clairemp25-prog/Projet-Piano-Num-rique-Ensea/Présentation finale.pdf

# PIANO NUMÉRIQUE

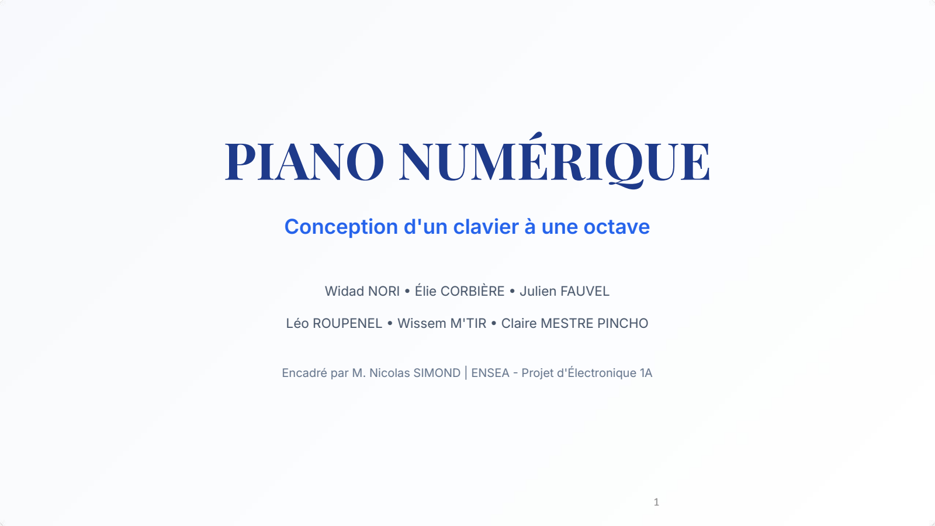
[picture p18: page 1]

## Conception d'un clavier à une octave

Encadré par M. Nicolas SIMOND | ENSEA Projet d'Électronique 1A

Widad NORI Élie CORBIÈRE Julien FAUVEL

Léo ROUPENEL Wissem M'TIR Claire MESTRE PINCHO

# Context & Introduction

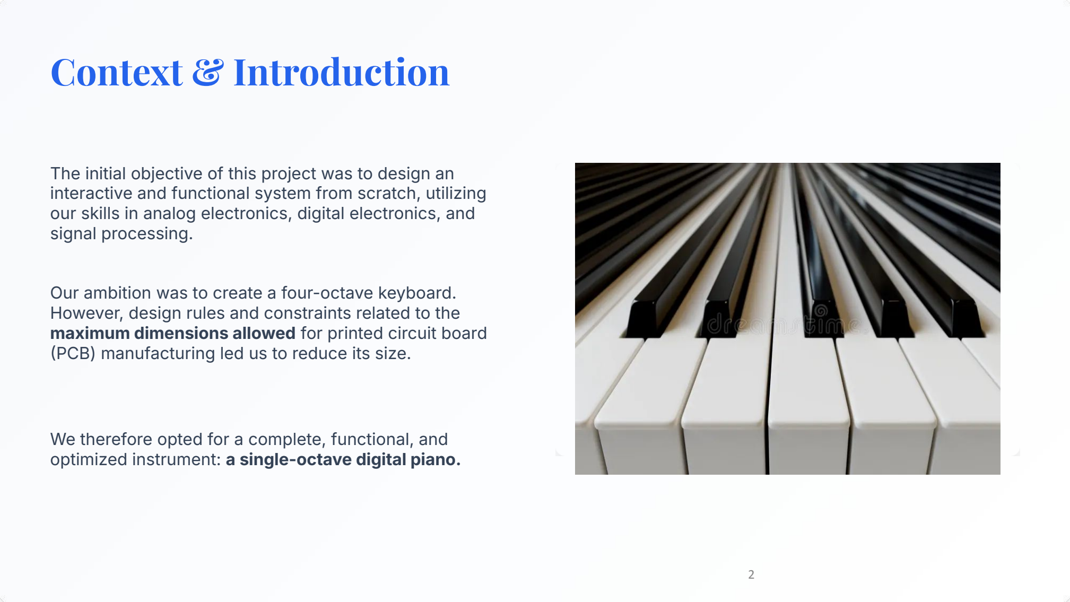
[picture p19: page 2]

The initial objective of this project was to design an interactive and functional system from scratch, utilizing our skills in analog electronics, digital electronics, and signal processing.

Our ambition was to create a four-octave keyboard. However, design rules and constraints related to the maximum dimensions allowed for printed circuit board PCB) manufacturing led us to reduce its size.

We therefore opted for a complete, functional, and optimized instrument: a single-octave digital piano.

# Project Specifications (SysML)

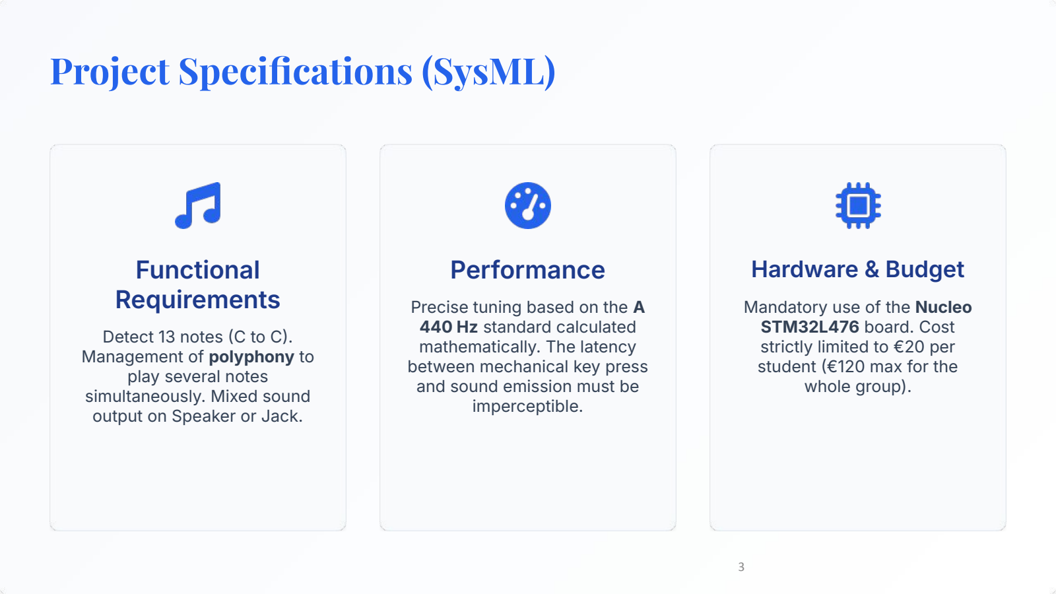
[picture p20: page 3]

## Functional Requirements

Detect 13 notes C to C.
Management of polyphony to play several notes
simultaneously. Mixed sound output on Speaker or Jack.

## Performance

Precise tuning based on the A 440 Hz standard calculated mathematically. The latency between mechanical key press and sound emission must be imperceptible.

## Hardware & Budget

Mandatory use of the Nucleo STM32L476 board. Cost
strictly limited to €20 per student €120 max for the
whole group).

# Diagramme SysML

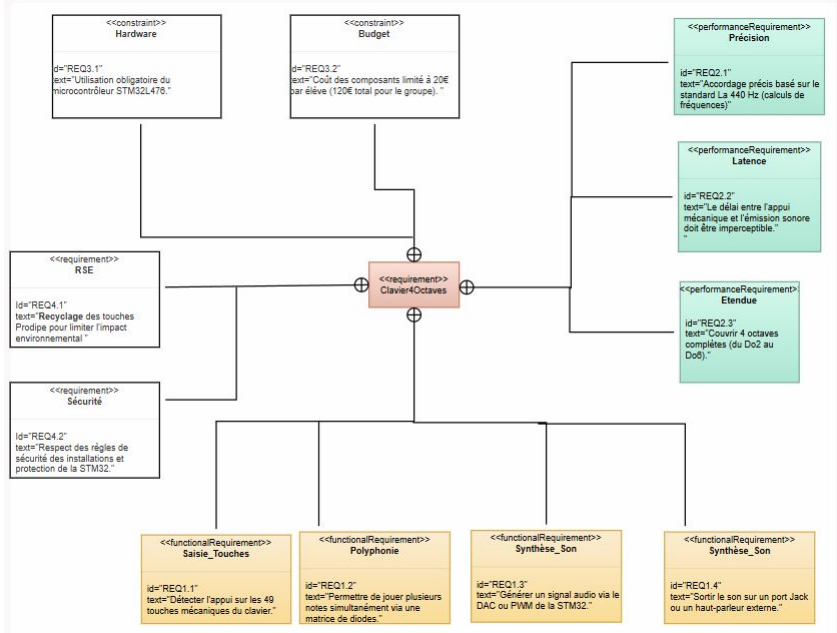
[picture p21: figure]

# System Architecture

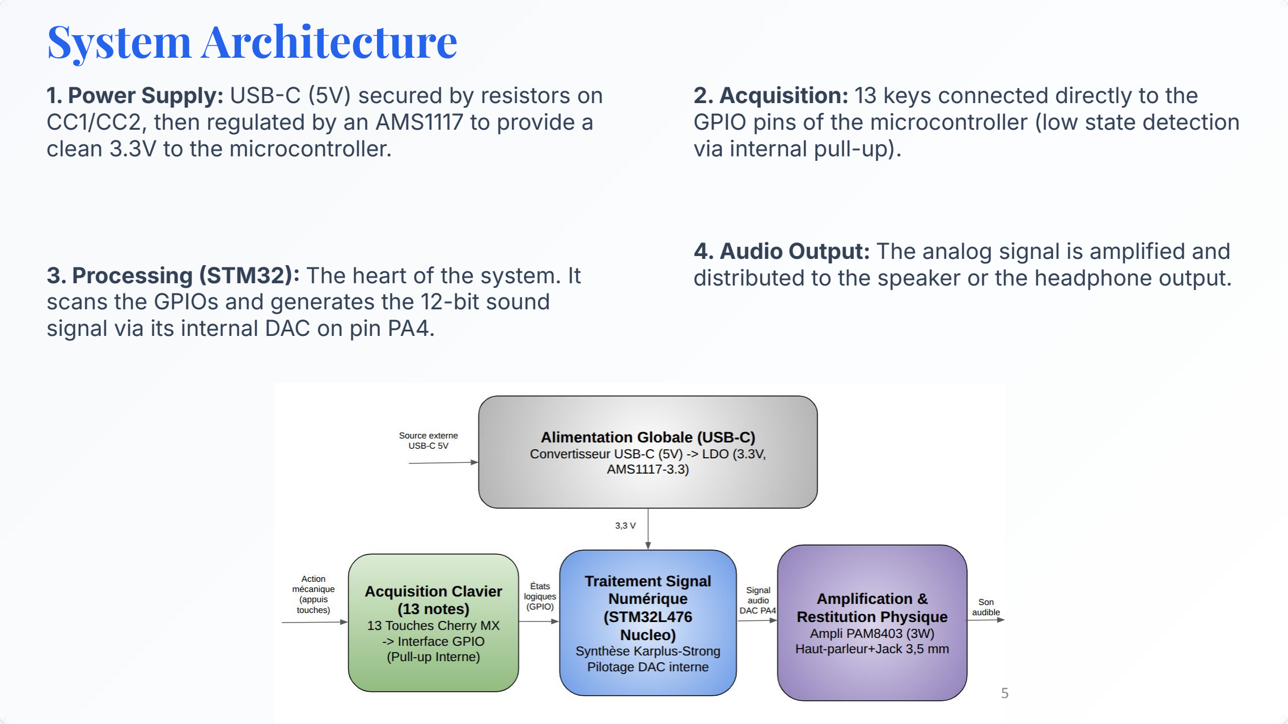
[picture p22: page 5]

### 1. Power Supply: USBC 5V) secured by resistors on

CC1/CC2, then regulated by an AMS1117 to provide a clean 3.3V to the microcontroller.

### 2. Acquisition: 13 keys connected directly to the

GPIO pins of the microcontroller (low state detection via internal pull-up).

### 3. Processing STM32 The heart of the system. It

scans the GPIOs and generates the 12-bit sound signal via its internal DAC on pin PA4.

### 4. Audio Output: The analog signal is amplified and

distributed to the speaker or the headphone output.

# Key Components

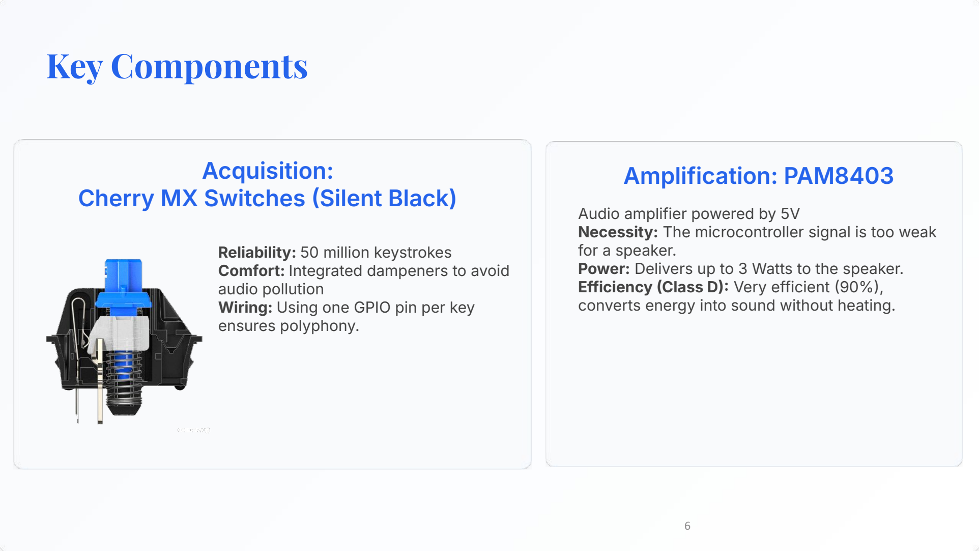
[picture p23: page 6]

## Acquisition: Cherry MX Switches Silent Black)

Reliability: 50 million keystrokes Comfort: Integrated dampeners to avoid audio pollution
Wiring: Using one GPIO pin per key ensures polyphony.

## Amplification: PAM8403

Audio amplifier powered by 5V
Necessity: The microcontroller signal is too weak for a speaker.
Power: Delivers up to 3 Watts to the speaker. Efficiency Class D Very efficient 90%, converts energy into sound without heating.

# List of components

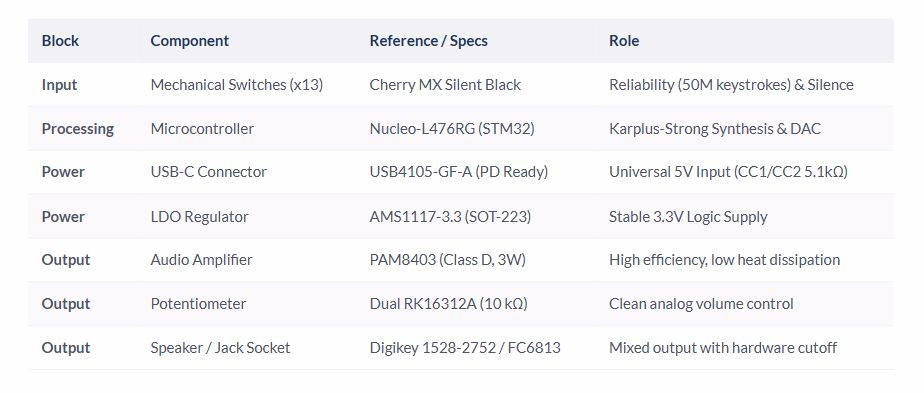
[picture p24: figure]
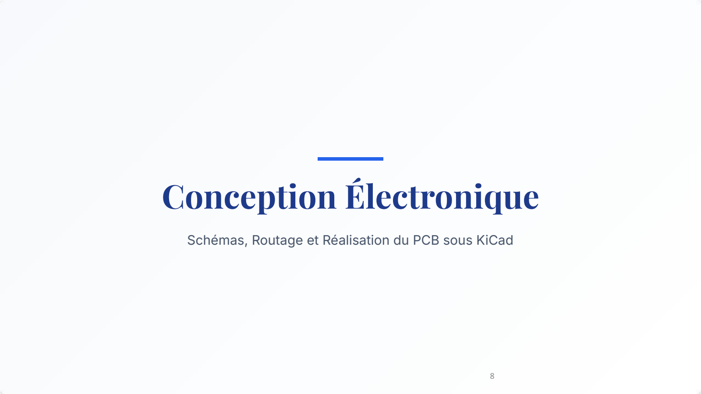
[picture p25: page 8]

# Conception Électronique

### Schémas, Routage et Réalisation du PCB sous KiCad

# CAO sous KiCad

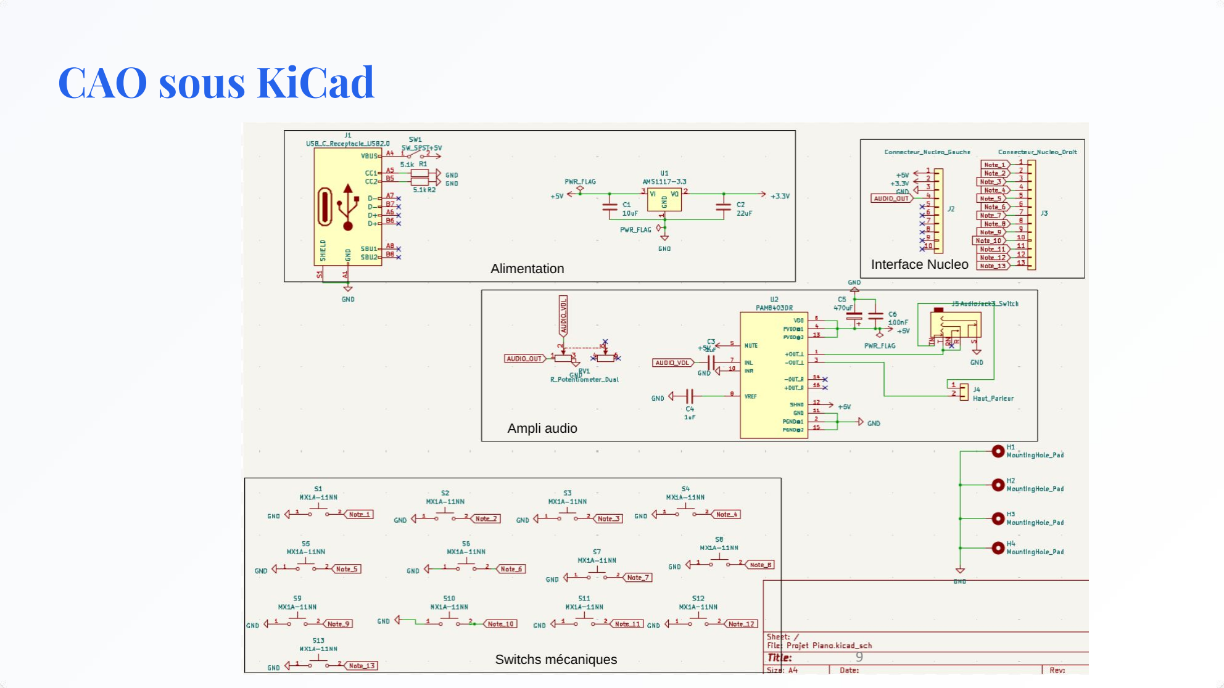
[picture p26: page 9]

# CONCEPTION DU PCB

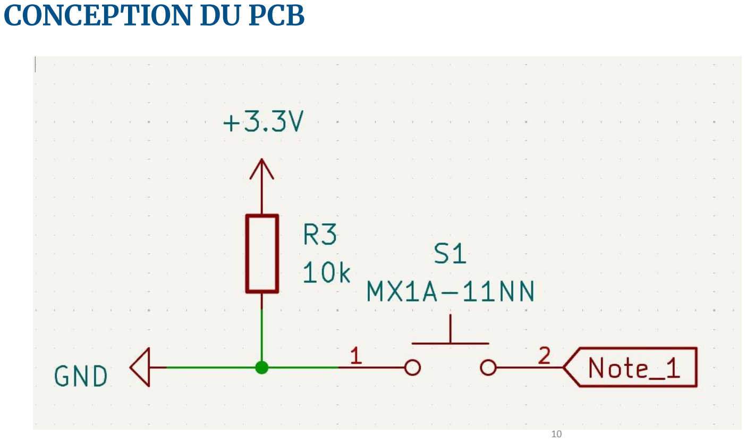
[picture p27: page 10]

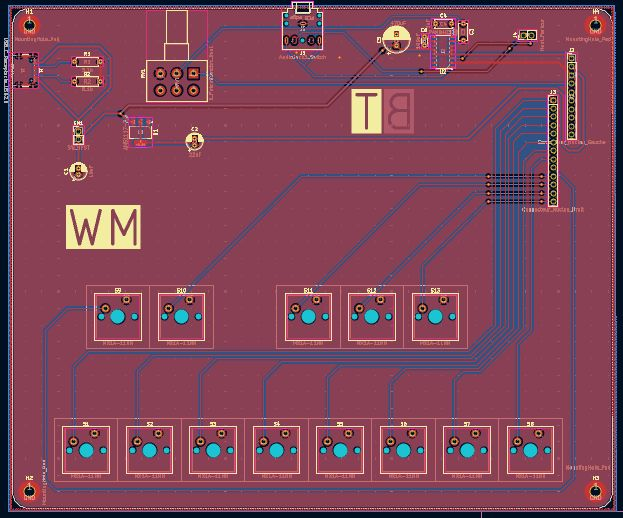
[picture p28: figure]

Routage 2 Couches

Pistes logiques au dos pour préserver le signal analogique de l'amplificateur en façade.

# CONCEPTION DU PCB

# CONCEPTION DU PCB

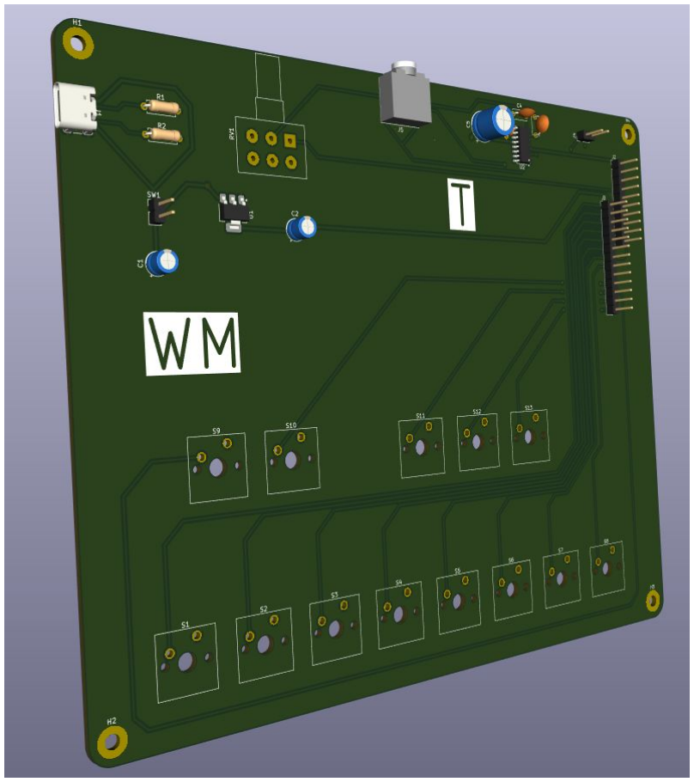
[picture p29: figure]

Vue 3D du PCB (KiCad)

"Shield" Format: The circuit was designed as an expansion board fitting directly onto the Nucleo via headers. This protects the microcontroller from permanent soldering.

Full Ground Plane: A copper fill connected to GND (zone fill) on both sides forms an essential electromagnetic shield to avoid background noise (hiss) in the audio signal.

Playing Ergonomics: The 13 Cherry MX footprints are precisely arranged to reproduce the standard spacing of a piano octave (aligned white keys, offset black keys).

USBC Security: Critical addition of two 5.1kΩ resistors on pins CC1/CC2 to force Power Delivery chargers to deliver only 5V (circuit protection).

# Printed Circuit Board Details

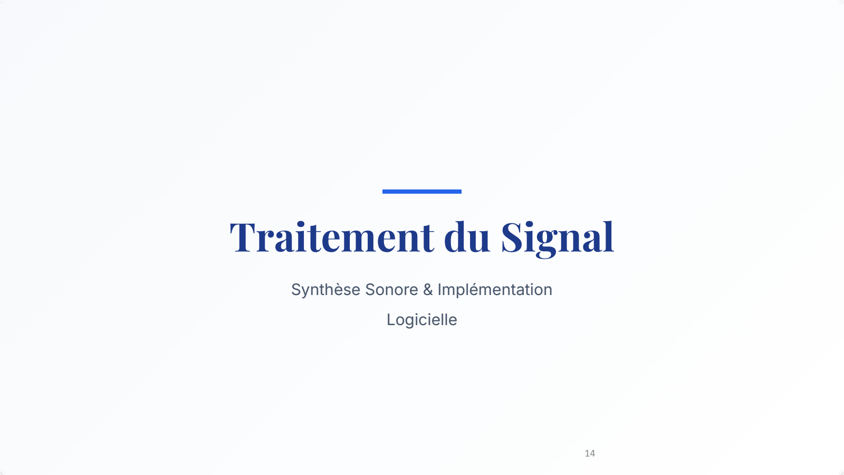
[picture p30: page 14]

# Traitement du Signal

### Synthèse Sonore & Implémentation Logicielle

# Algorithm Choice

To synthesize the piano sound, we had to choose between several methods:

- Additive synthesis: We add elementary signals to simulate a piano sound
- FM synthesis: Method using frequency modulation to synthesize a sound
- Karplus-Strong algorithm: A white noise loop is played back on itself and filtered with a low-pass filter

# Additive synthesis

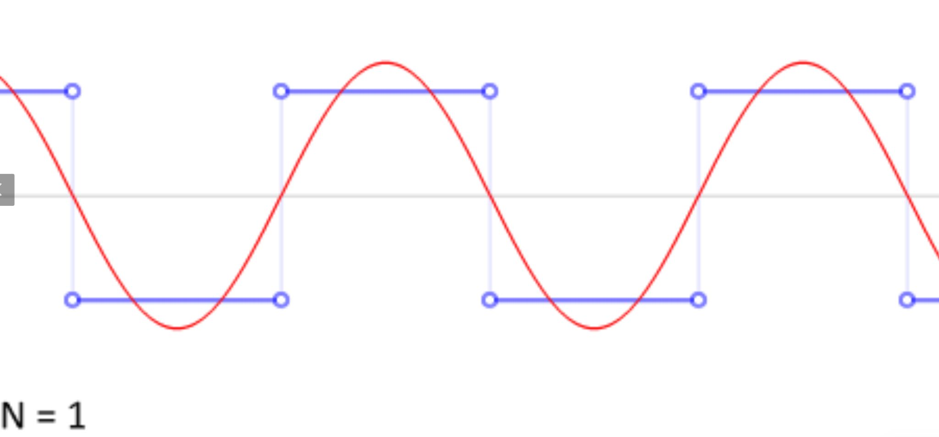
[picture p31: figure]

Pros and cons :
- Simple to implement: Very simple method
- Very heavy : If we want to synthesize a high-quality sound, we need a large amount of harmonics, which takes a lot of calculation time
- Rich sound: We directly control the amount of harmonics, the result can be rich and easily adjustable
- Originality : method with little interest

# Additive synthesis

Pros and cons :

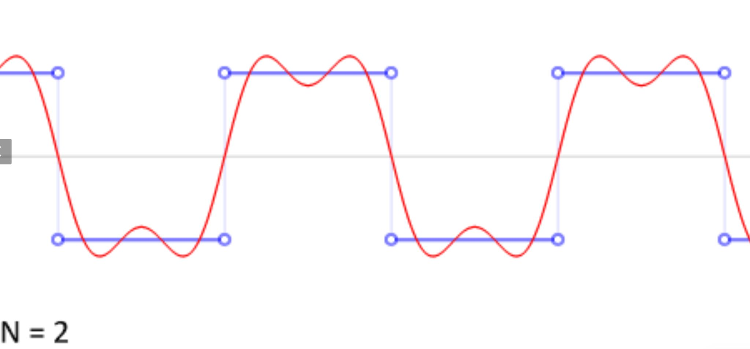
[picture p32: figure]

- Simple to implement: Very simple method
- Very heavy : If we want to synthesize a high-quality sound, we need a large amount of harmonics, which takes a lot of calculation time
- Rich sound: We directly control the amount of harmonics, the result can be rich and easily adjustable
- Originality : method with little interest

# Additive synthesis

Pros and cons :

- Simple to implement: Very simple method

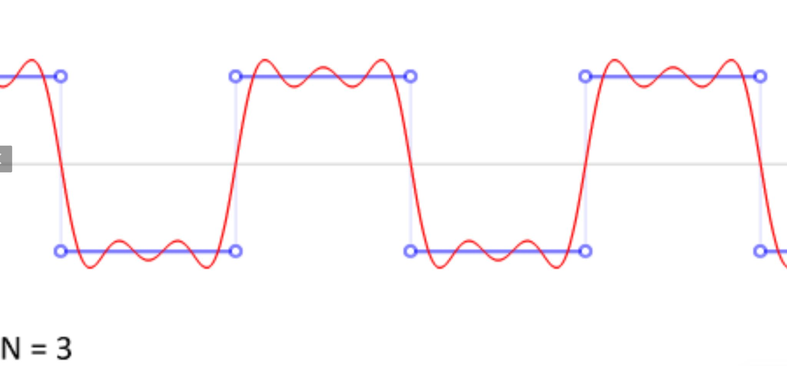
[picture p33: figure]

- Very heavy : If we want to synthesize a high-quality sound, we need a large amount of harmonics, which takes a lot of calculation time
- Rich sound: We directly control the amount of harmonics, the result can be rich and easily adjustable
- Originality : method with little interest

# FM Synthesis (frequency modulation)

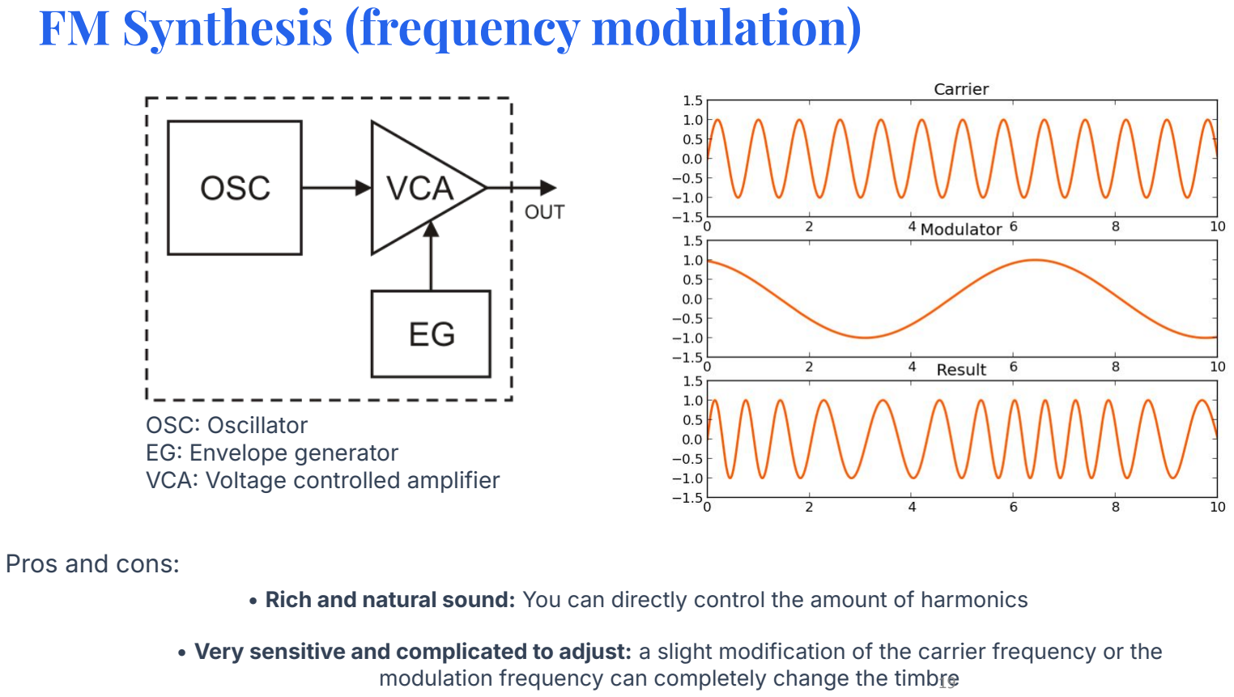
[picture p34: page 19]

OSC Oscillator
EG Envelope generator
VCA Voltage controlled amplifier

Pros and cons:
- Rich and natural sound: You can directly control the amount of harmonics
- Very sensitive and complicated to adjust: a slight modification of the carrier frequency or the modulation frequency can completely change the timbre19

# The Karplus-Strong Algorithm

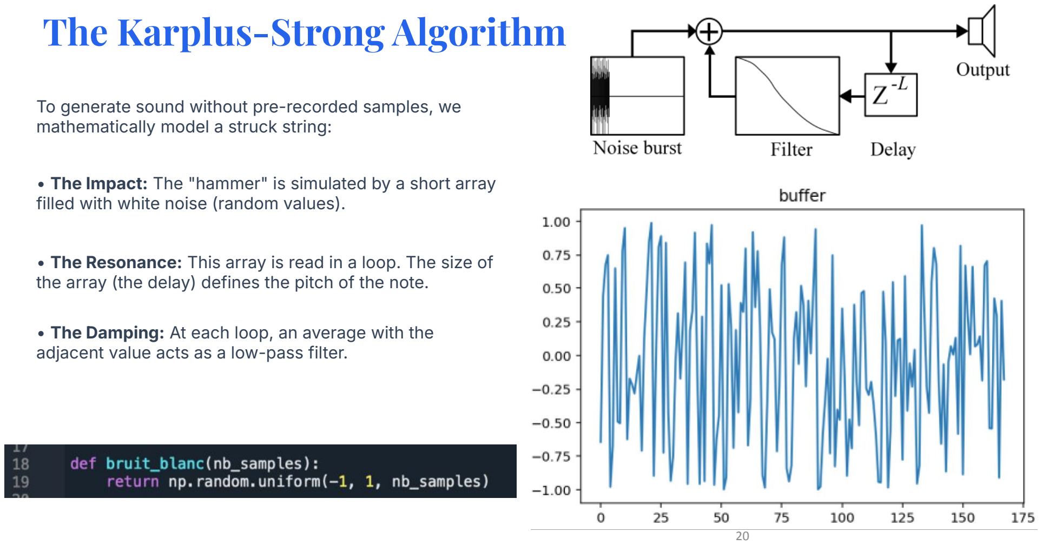
[picture p35: page 20]

To generate sound without pre-recorded samples, we mathematically model a struck string:

- The Impact: The "hammer" is simulated by a short array filled with white noise (random values).
- The Resonance: This array is read in a loop. The size of the array (the delay) defines the pitch of the note.
- The Damping: At each loop, an average with the adjacent value acts as a low-pass filter.

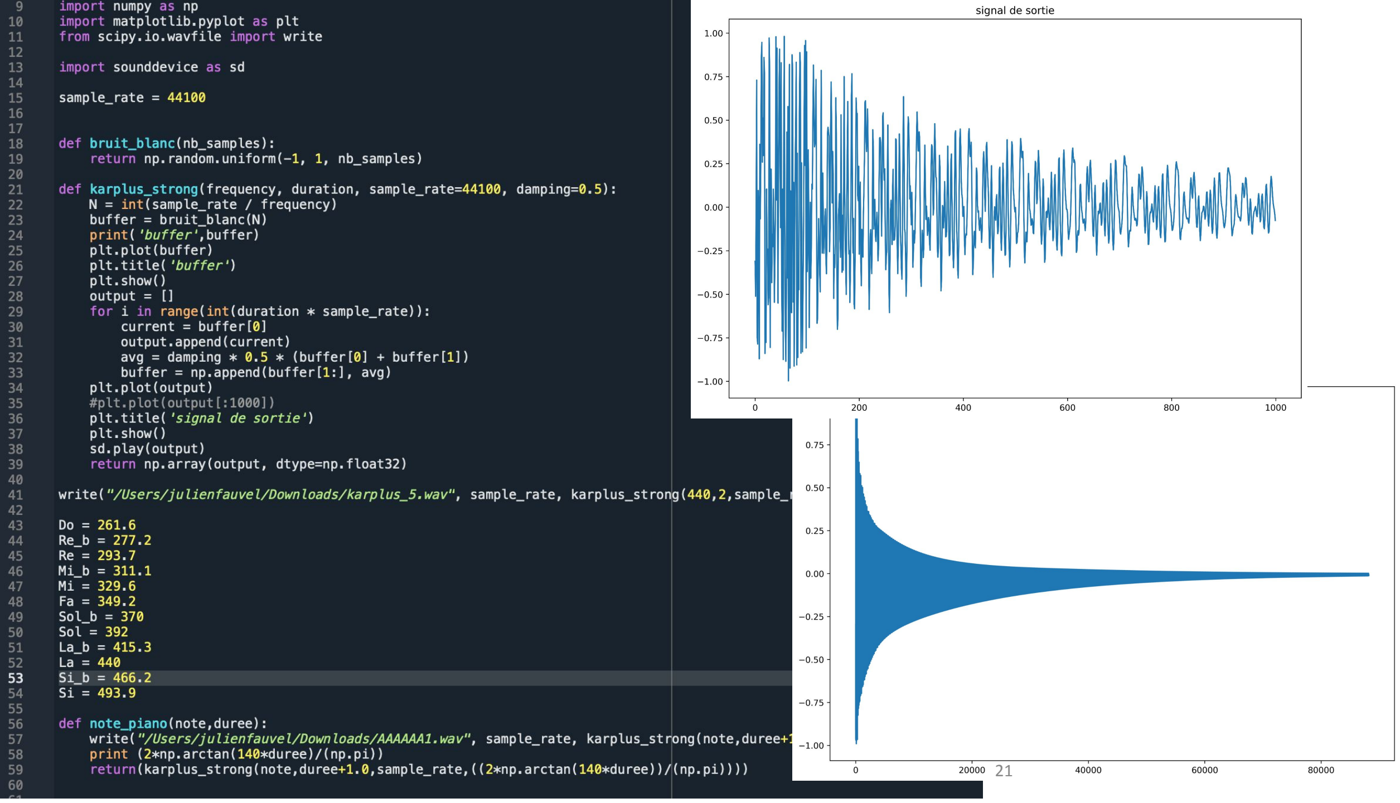
[picture p36: page 21]

# polyphony and analog synthesis

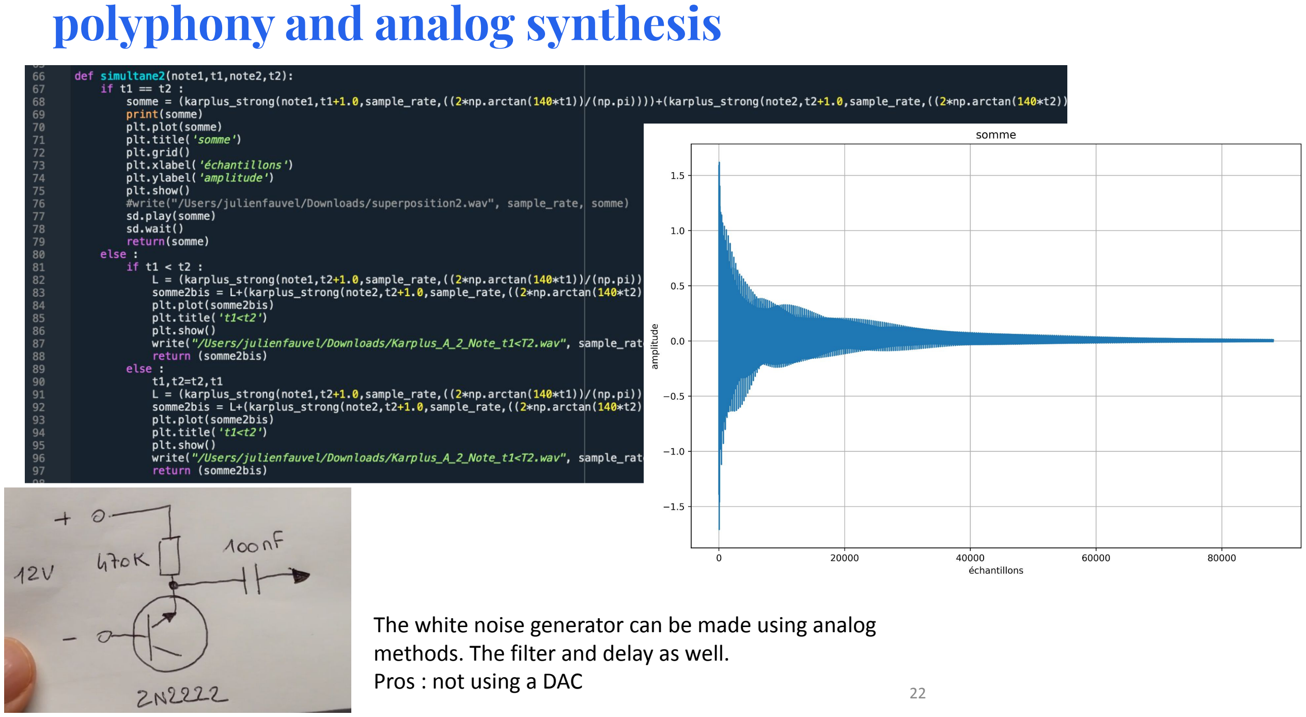
[picture p37: page 22]

The white noise generator can be made using analog methods. The filter and delay as well.
Pros : not using a DAC

# Implémentation Logicielle en C

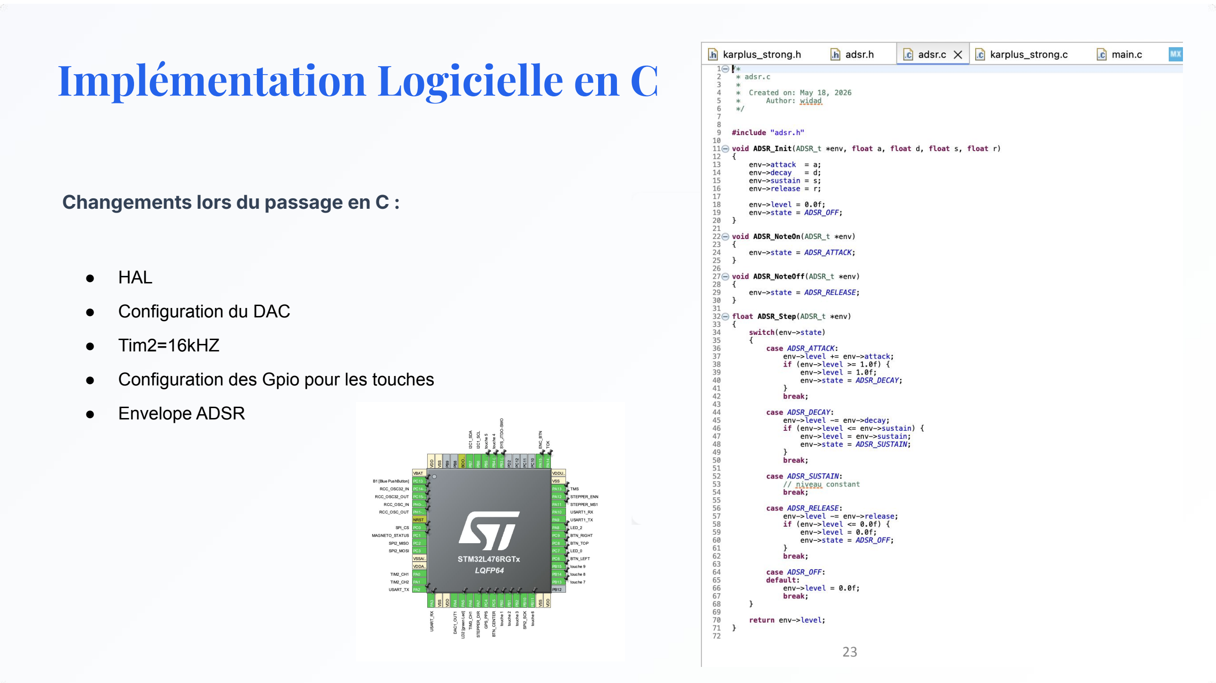
[picture p38: page 23]

Changements lors du passage en C :

- HAL
- Configuration du DAC
- Tim2=16kHZ
- Configuration des Gpio pour les touches
- Envelope ADSR

# Implémentation Logicielle en C

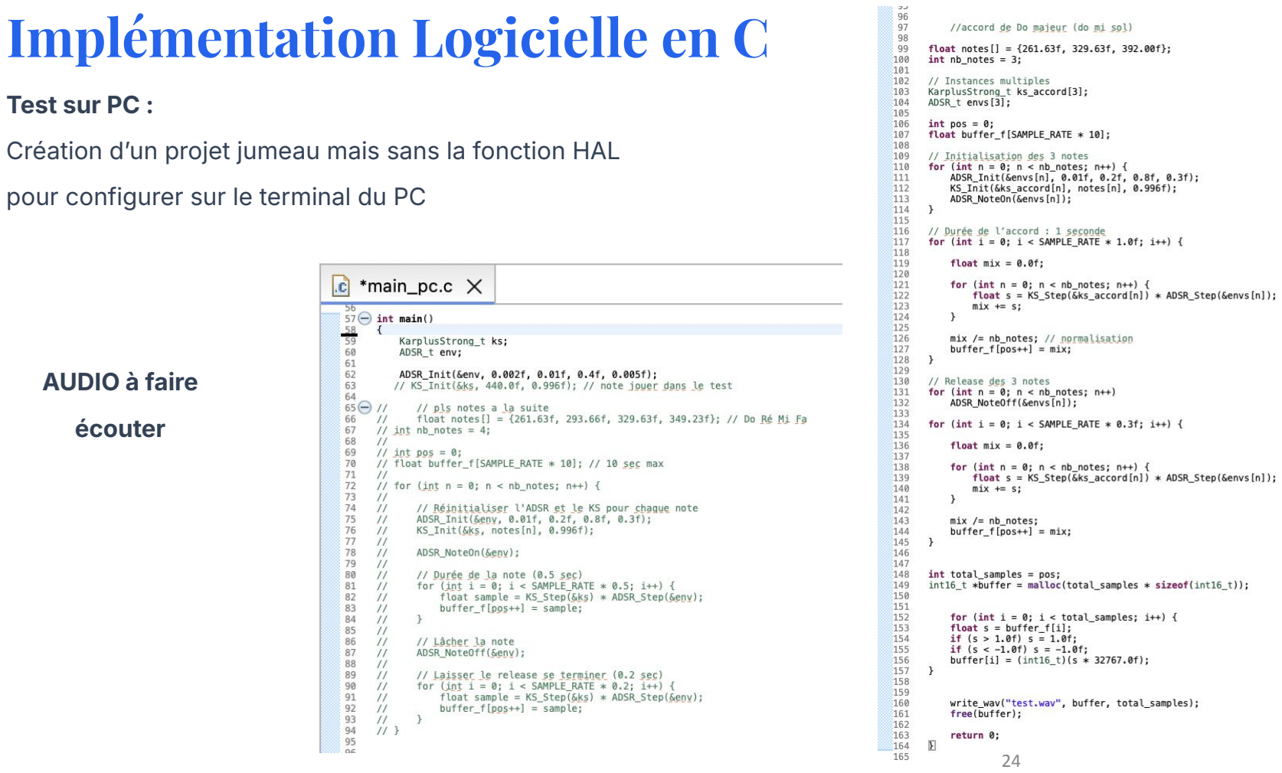
[picture p39: page 24]

Test sur PC :
Création dʼun projet jumeau mais sans la fonction HAL pour configurer sur le terminal du PC

AUDIO à faire
écouter

SMT Reflow Soldering: Solder paste application via stencil for surface-mount components AMS1117 regulator, Amplifier, USB, followed by a pass through the thermal oven.

Manual THT Soldering: Traditional iron soldering for all through-hole components Cherry MX switches, electrolytic capacitors, Jack, potentiometer).

Troubleshooting: Missing footprints for pull-up resistors 10kΩ) on the original layout. We bypassed the issue by manually soldering them to the back of the board, directly onto the switch pins.

Testing: Oscilloscope verification of GPIO signals, the correct Timer frequency 44.1kHz), and clean 3.3V voltage before connecting the Nucleo.

# Hardware Assembly

# Soldering and 3D Printing

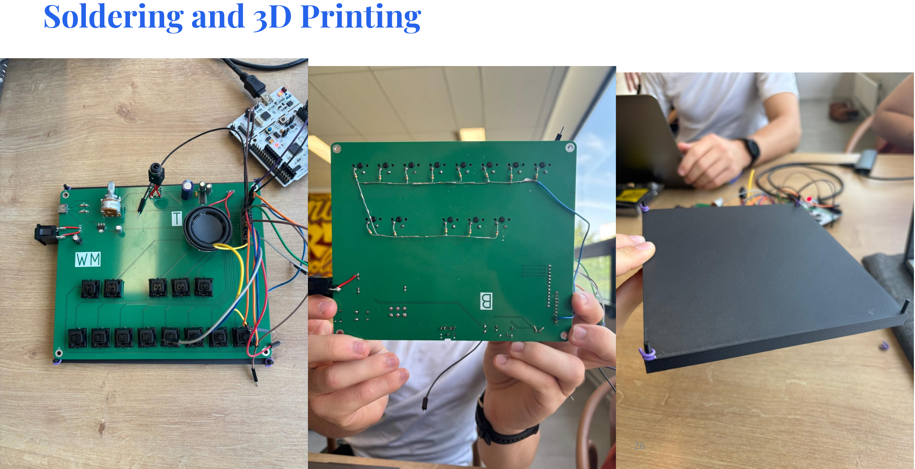
[picture p40: page 26]

# Time Management

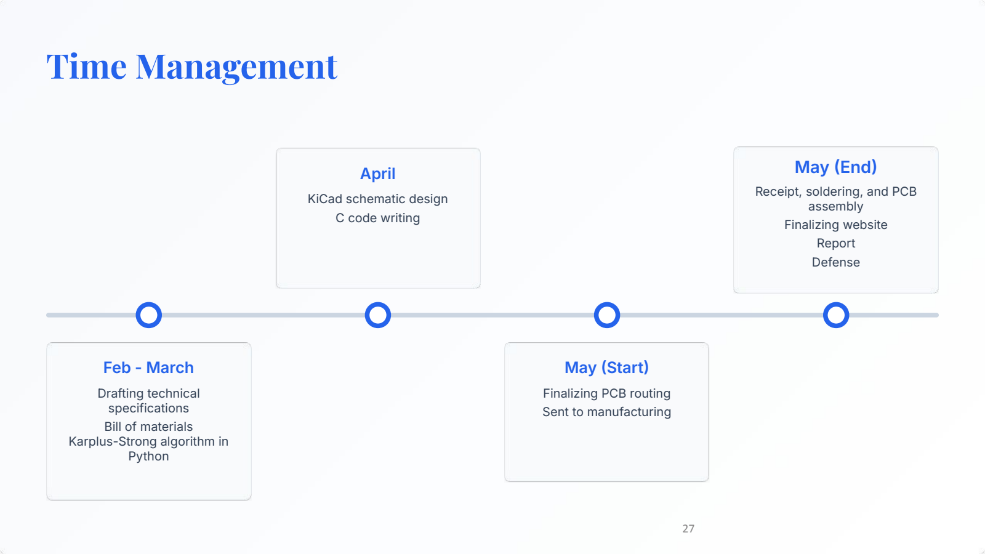
[picture p41: page 27]

Feb - March

Drafting technical
specifications
Bill of materials
Karplus-Strong algorithm in Python

April

KiCad schematic design
C code writing

May Start

Finalizing PCB routing
Sent to manufacturing

May End

Receipt, soldering, and PCB assembly
Finalizing website
Report
Defense

## CSR Approach

## Future Improvements

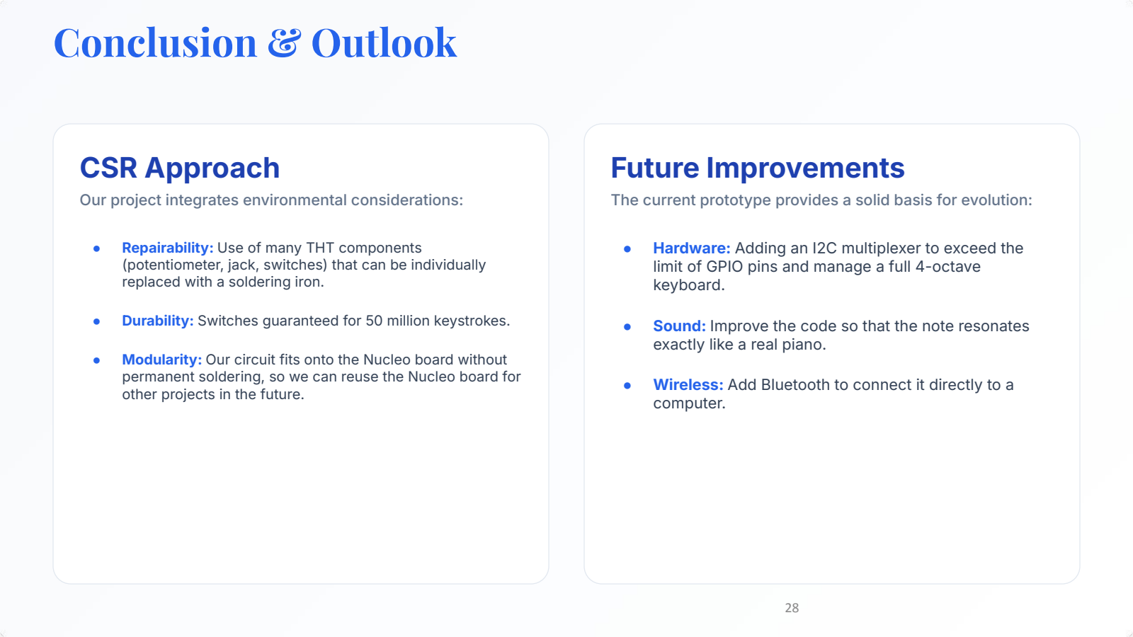
[picture p42: page 28]

Our project integrates environmental considerations:

The current prototype provides a solid basis for evolution:

- Repairability: Use of many THT components (potentiometer, jack, switches) that can be individually replaced with a soldering iron.
- Durability: Switches guaranteed for 50 million keystrokes.
- Modularity: Our circuit fits onto the Nucleo board without permanent soldering, so we can reuse the Nucleo board for other projects in the future.
- Hardware: Adding an I2C multiplexer to exceed the limit of GPIO pins and manage a full 4-octave keyboard.
- Sound: Improve the code so that the note resonates exactly like a real piano.
- Wireless: Add Bluetooth to connect it directly to a computer.

# Conclusion & Outlook

# Merci de votre attention

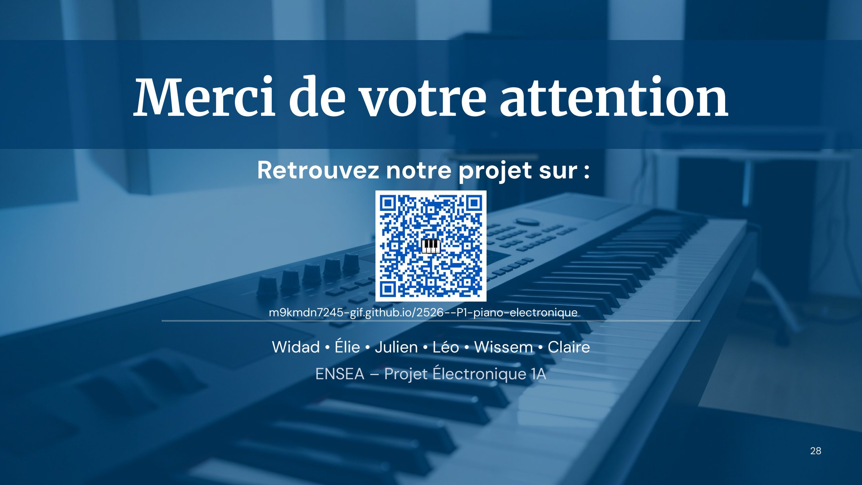
[picture p43: page 29]

# Retrouvez notre projet sur :

m9kmdn7245-gif.github.io/2526--P1-piano-electronique

### Widad • Élie • Julien • Léo • Wissem • Claire ENSEA – Projet Électronique 1A

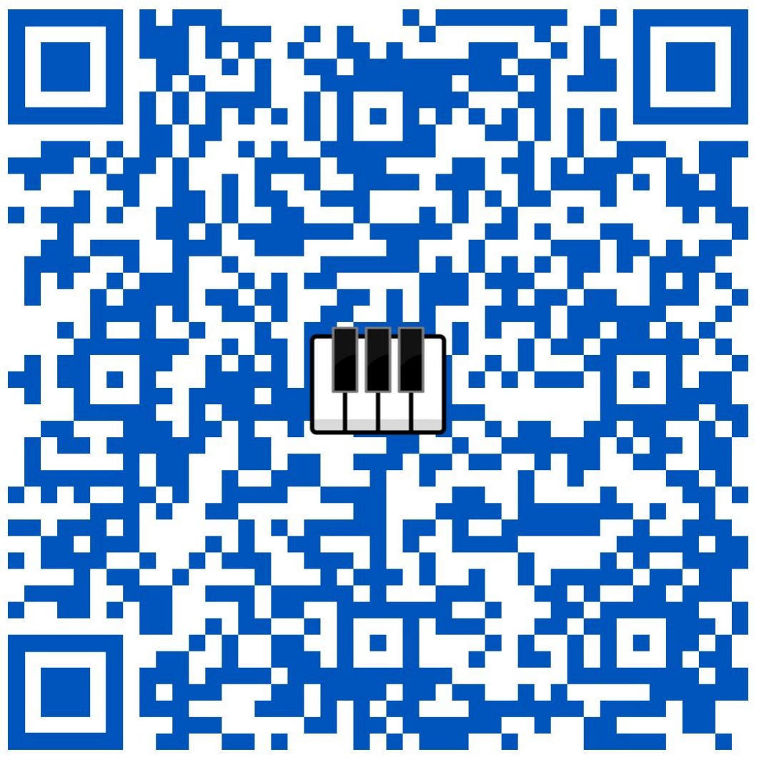
[picture p44: figure]
