clairemp25-prog/Projet-Piano-Num-rique-Ensea/Présentation de mi-parcours.pdf

# Developing a Digital Piano : One Octave Range

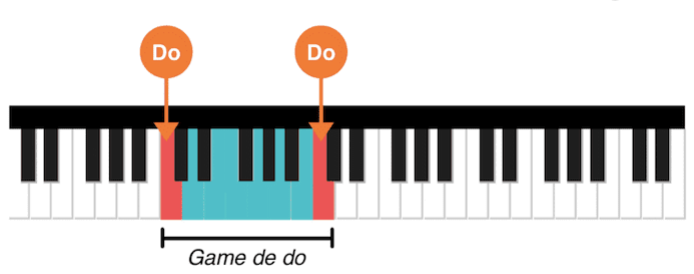
[picture p45: figure]

Widad Nori
Elie Corbière
Julien Fauvel
Léo Roupenel
Wissem M’Tir
Claire Mestre Pincho

# TASKDISTRIBUTION

## Project & Task Management : Léo Roupenel

## Time Management & Deadlines : Julien Fauvel

## Procurement & Ordering : Widad Nori

## Testing & Quality Control : Wissem M’tir

## Weekly Reports & Website : Elie Corbière

## Final Report & Presentation : Claire Mestre Pincho

1.Acquisition | 2.Processing
3.Power Supply | 4.Output

Convert a key press into an electrical signal
readable by the microcontroller.

Analyze input signals in real-time and mathematically generate the corresponding audio signal (handled by the Nucleo board)

Provide a stable and safe voltage to all internal components.

Amplify the electrical signal from processing and convert it into audible sound waves.

# System Architecture

### Acquisition

How to detect key presses across multiple keys ? What type of buttons : Hall effect (magnetic) vs. mechanical switches ?

### Processing

How to generate the audio signal ? How to manage the note envelope (attack/decay) ? How to handle polyphony ?

### Power Supply

Battery (9V) vs. USB source ?

### Output

Headphone jack, integrated speaker, or both ? Bluetooth integration ?

# Initial Questions & Challenges

# Technical Specifications & SysML Requirements Diagram

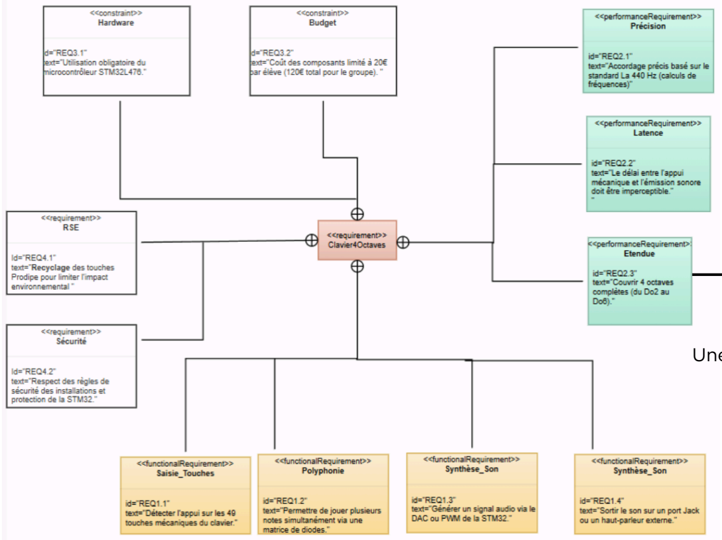
[picture p46: figure]

Une octave (13 notes)

# 1.Acquisition

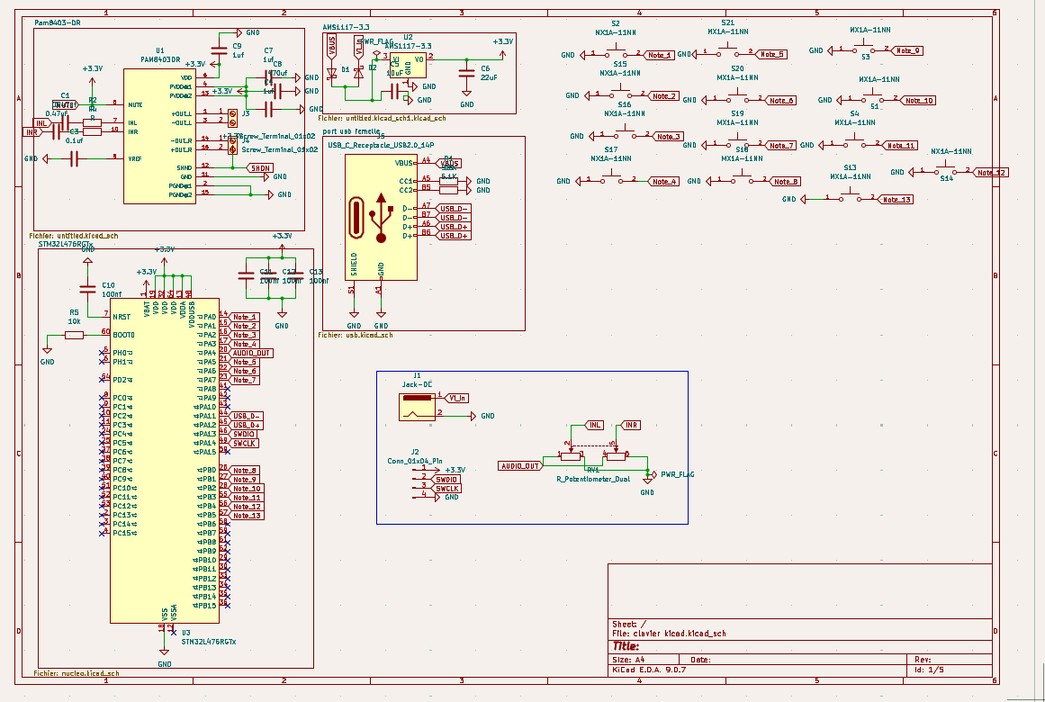
[picture p47: figure]

# 1.Acquisition : From questions to solutions

How to detect key presses across multiple keys ? What type of buttons : Hall effect (magnetic) vs. mechanical switches (Cherry MX) ?

→ Selection of 13 Cherry MX Black Silent mechanical switches (one full octave, from C to C).

# 2.Processing : From questions to solutions

How to generate the audio signal ? How to manage the note envelope (attack/decay) ? How to handle polyphony ?

→ Sine wave generation via the integrated DAC. → Note envelope management (attack/decay) using an additive synthesis algorithm. → Prototype developed in Python then ported to C.

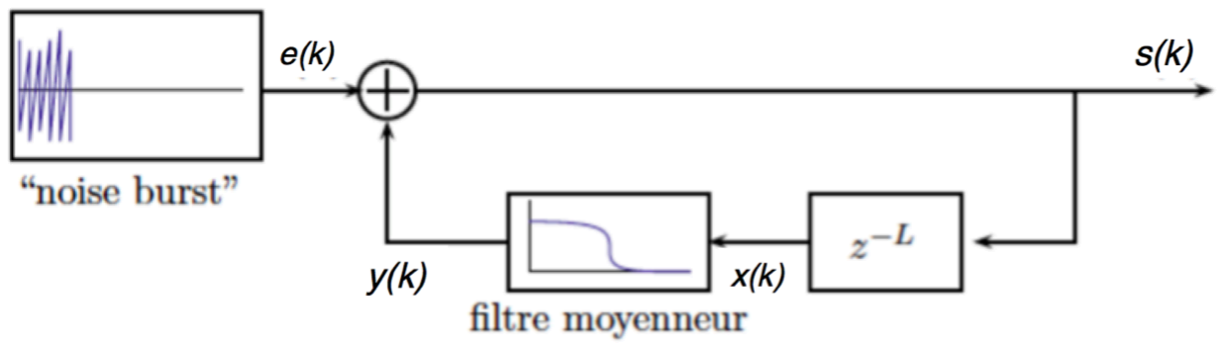
[picture p48: figure]

# Karplus Strong algorithm in python

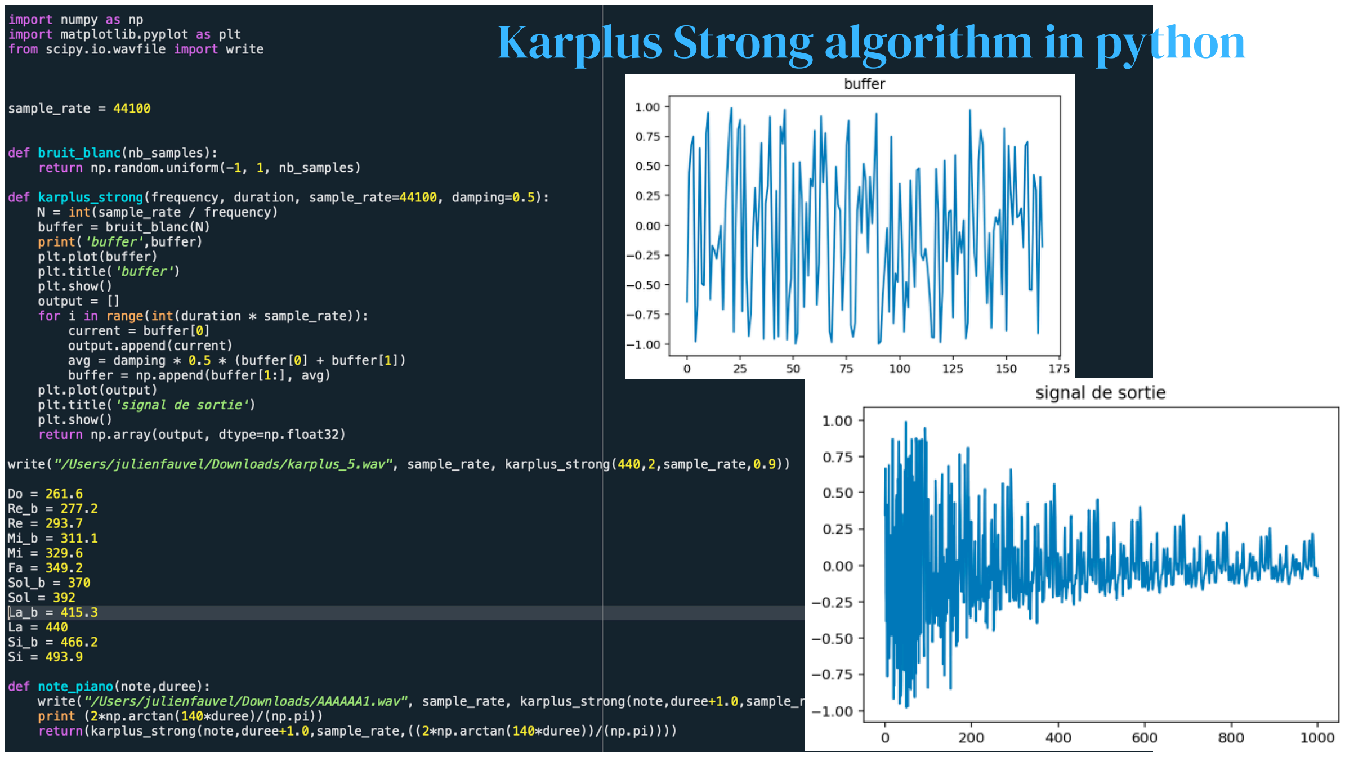
[picture p49: page 9]

# Programming

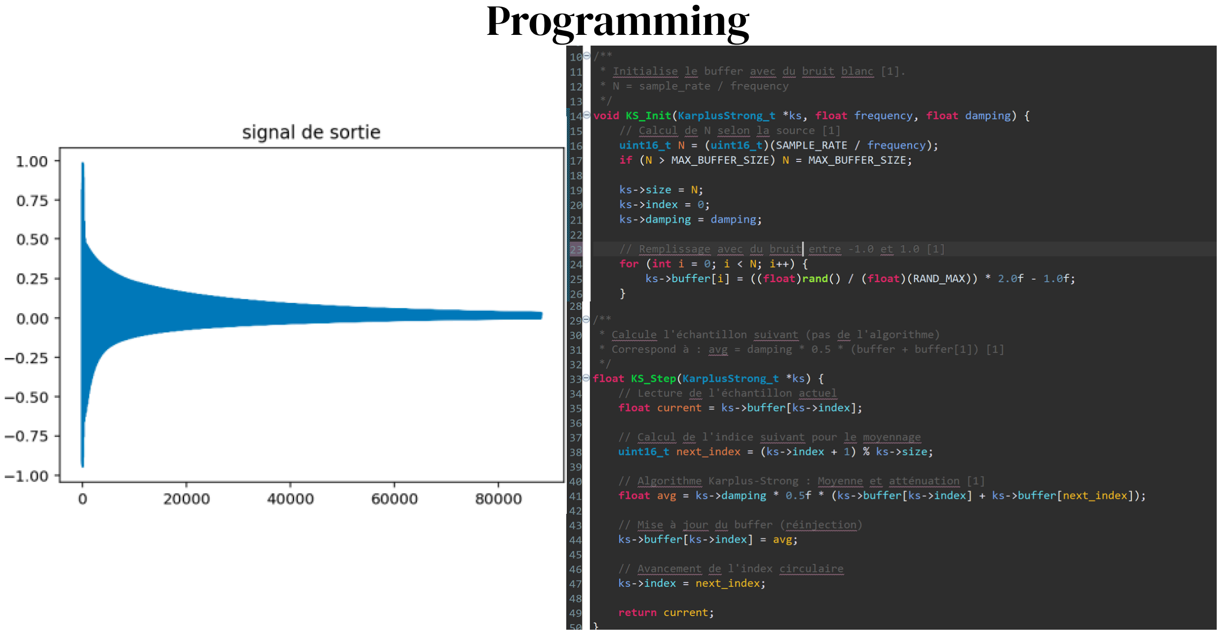
[picture p50: page 10]

# 3.Power Supply : From questions to solutions

Battery (9V) vs. USB source ?

→ USB-C source : More modern and reliable than 9V batteries. → AMS1117-3.3 Regulator : Ensures a stable 3.3V supply for sensitive components.

# 4.Output : From questions to solutions

Headphone jack, integrated speaker, or both ? Bluetooth integration ?

→ Hybrid system with both an Integrated Speaker and a 3.5mm Jack. → Audio signal boosted by an Amplifier. → Volume control via a 10 kΩ Potentiometer. → Bluetooth excluded to avoid latency and simplify design.

1.Acquisition | 2.Processing List of components

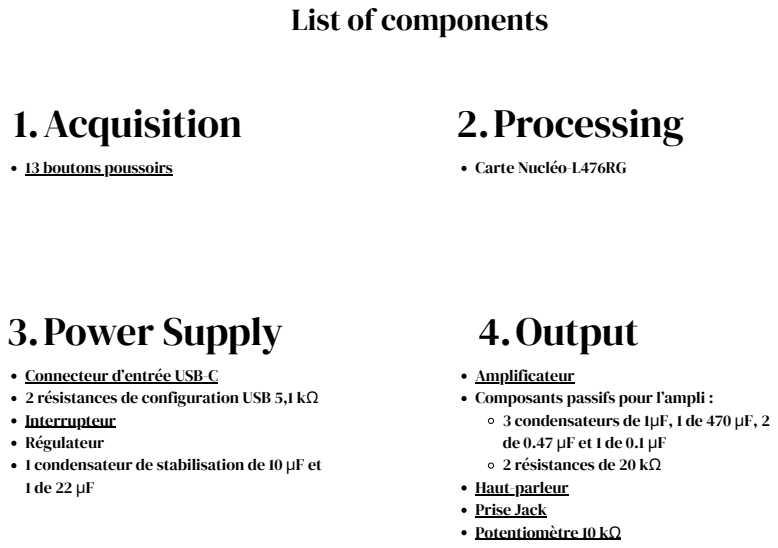
[picture p51: page 13]
3.Power Supply; 4.Output; 13 boutons poussoirs; Carte Nucléo-L476RG

Connecteur d’entrée USB-C
2 résistances de configuration USB 5,1 kΩ
Interrupteur
Régulateur
1 condensateur de stabilisation de 10 μF et

Amplificateur
Composants passifs pour l’ampli :
3 condensateurs de 1μF, 1 de 470 μF, 2
2 résistances de 20 kΩ
Haut-parleur
Prise Jack
Potentiomètre 10 kΩ

# List of components

# Project Timeline

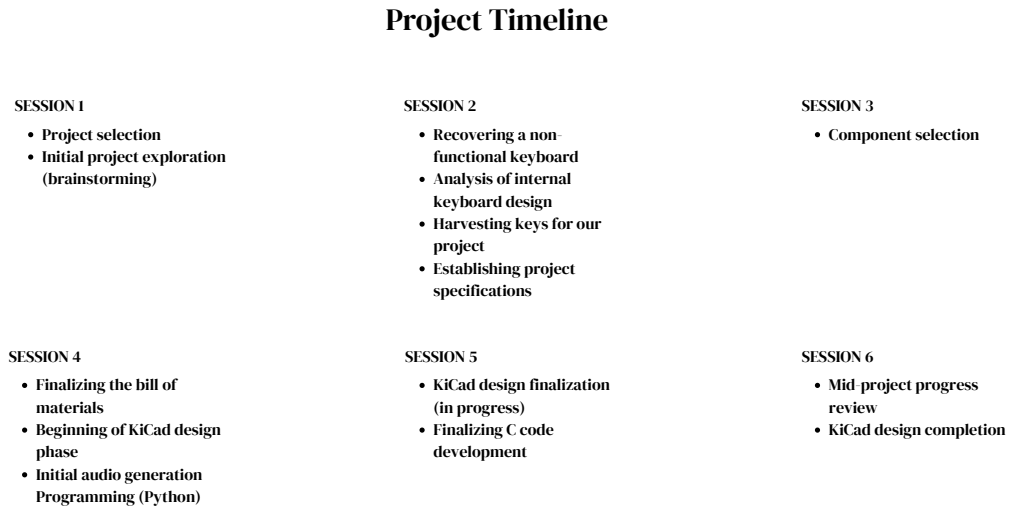
[picture p52: page 15]
SESSION 1; SESSION 2; SESSION 3; SESSION 4; SESSION 5; SESSION 6; Component selection

Project selection
Initial project exploration
(brainstorming)

Recovering a non-
functional keyboard
Analysis of internal
keyboard design
Harvesting keys for our
project
Establishing project
specifications

Finalizing the bill of
materials
Beginning of KiCad design
phase
Initial audio generation
Programming (Python)

KiCad design finalization
(in progress)
Finalizing C code
development

Mid-project progress
review
KiCad design completion

SESSION 7 | SESSION 8 | SESSION 9

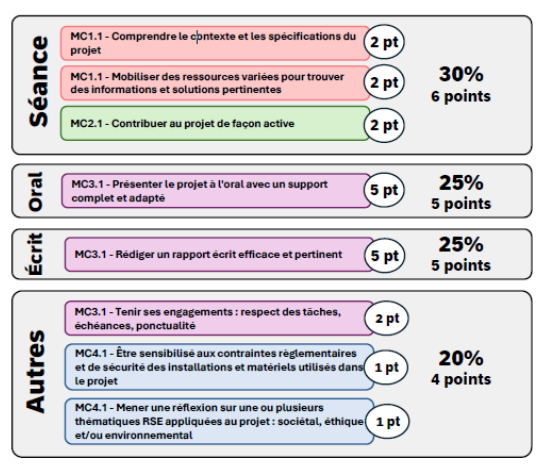
[picture p53: figure]

SESSION 10

Soldering
Report drafting

Soldering
Core competency (MC)
self-assessment (Sessions
& Others)
Report drafting

Final report completion

Final core competency
(MC) self-assessment (Oral & Written)
Final report submission,
archiving, and final
defense with demos
