clairemp25-prog/Projet-Piano-Num-rique-Ensea/clavier kicad/Projet Piano.kicad_pcb

## KiCad design clavier kicad/Projet Piano.kicad_pcb (2026-05-28)

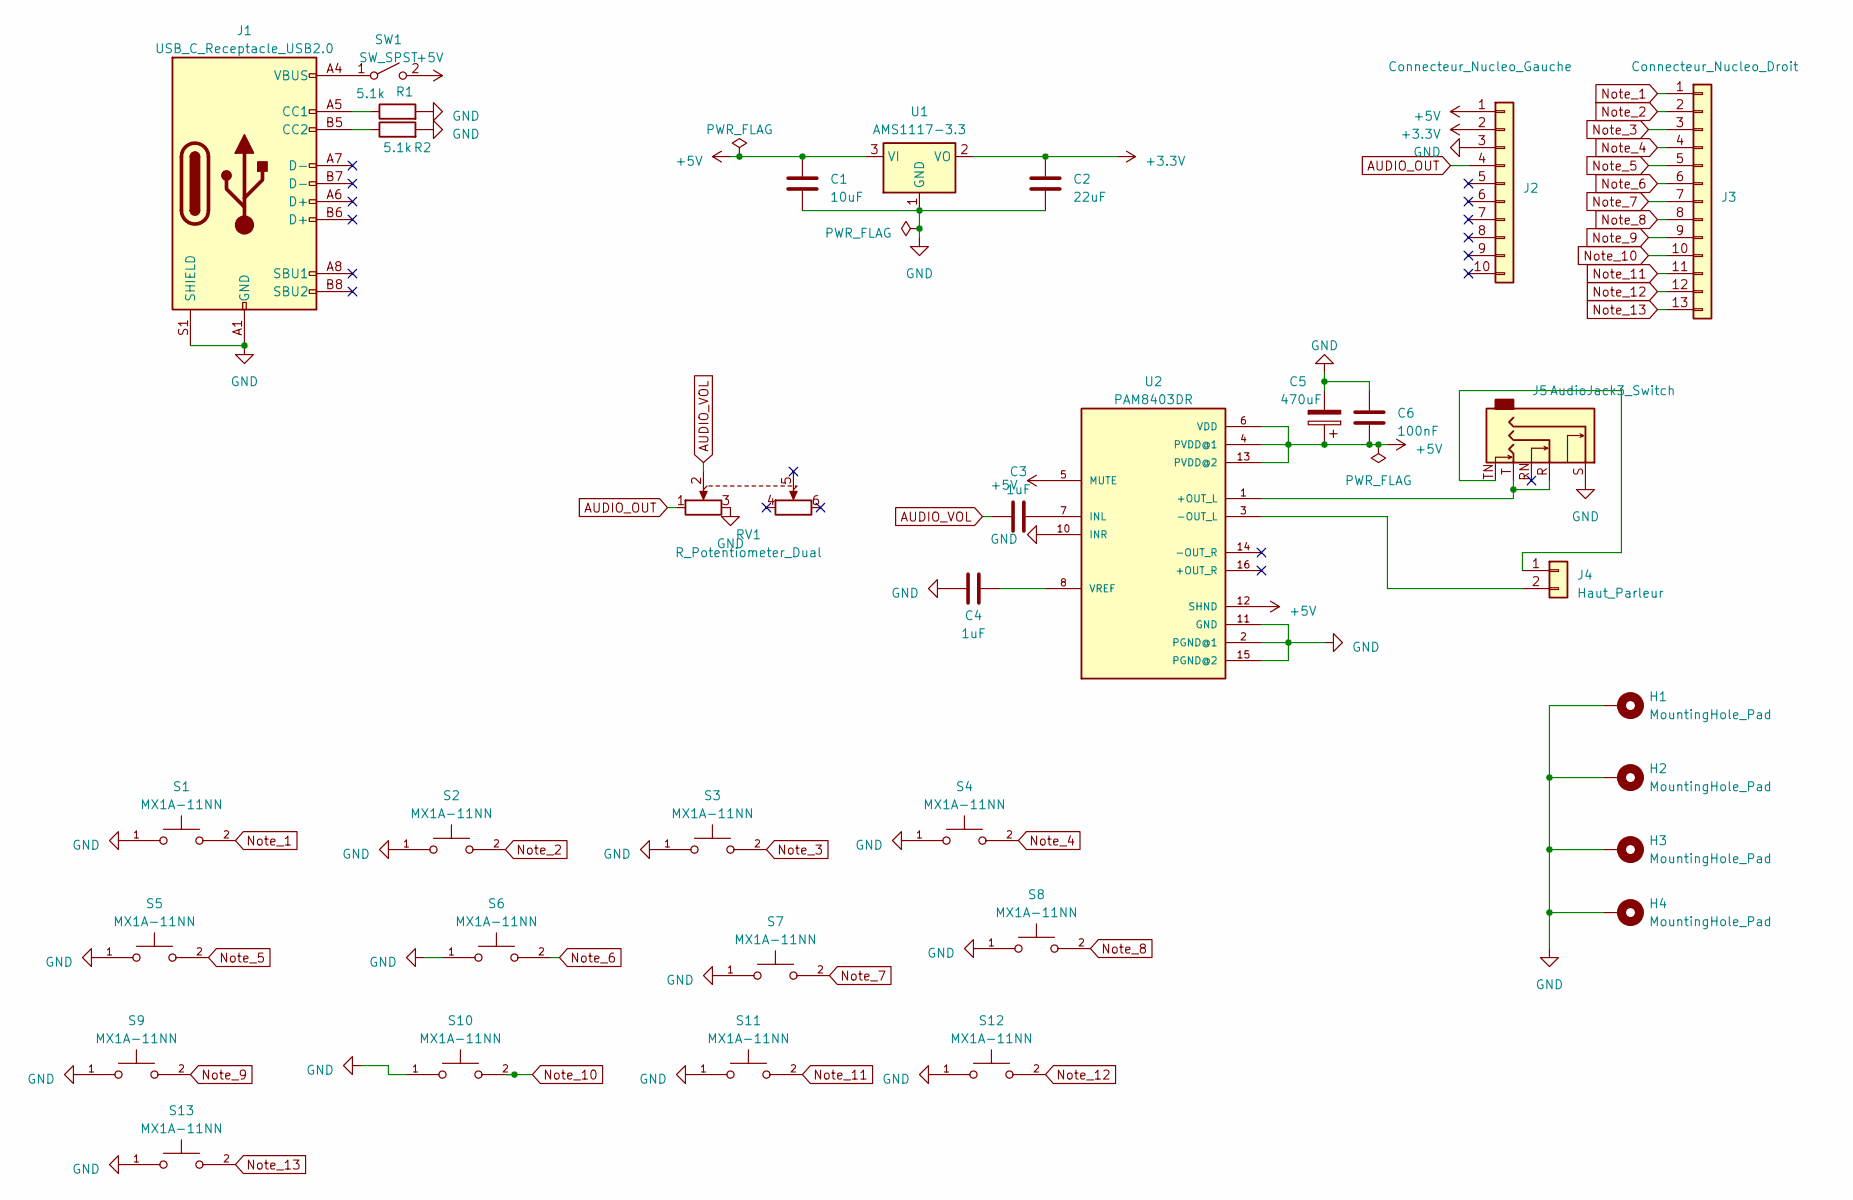
[picture p54: schematic Projet Piano.kicad_sch]

Parts:
C1: 10uF; CP_Radial_D5.0mm_P2.00mm
C2: 22uF; CP_Radial_D5.0mm_P2.00mm
C3, C4: 1uF; C_Disc_D5.0mm_W2.5mm_P5.00mm
C5: 470uF; CP_Radial_D8.0mm_P3.50mm
C6: 100nF; C_Disc_D3.0mm_W1.6mm_P2.50mm
H1, H2, H3, H4: MountingHole_Pad; MountingHole_3.2mm_M3_Pad
J1: USB_C_Receptacle_USB2.0; USB_C_Receptacle_GCT_USB4105-xx-A_16P_TopMnt_Horizontal
J2: Connecteur_Nucleo_Gauche; PinHeader_1x10_P2.54mm_Vertical
J3: Connecteur_Nucleo_Droit; PinHeader_1x13_P2.54mm_Vertical
J4: Haut_Parleur; PinHeader_1x02_P2.54mm_Vertical
J5: AudioJack3_Switch; Jack_3.5mm_CUI_SJ1-3525N_Horizontal
R1, R2: 5.1k; R_Axial_DIN0207_L6.3mm_D2.5mm_P7.62mm_Horizontal
RV1: R_Potentiometer_Dual; Potentiometer_Alps_RK163_Dual_Horizontal
S1, S2, S3, S4, S5, S6, S7, S8, S9, S10, S11, S12, S13: MX1A-11NN; SW_Cherry_MX_1.00u_PCB
SW1: SW_SPST; PinHeader_1x02_P2.54mm_Vertical
U1: AMS1117-3.3; SOT-223-3_TabPin2
U2: PAM8403DR; SO-16_3.9x9.9mm_P1.27mm

Connections:
+3.3V: C2.2, J2.2, U1.2 (VO)
+5V: C1.2, C5.1, C6.2, J2.1, SW1.2 (B), U1.3 (VI), U2.4 (PVDD@1), U2.5 (MUTE), U2.6 (VDD), U2.12 (SHND), U2.13 (PVDD@2)
AUDIO_OUT: J2.4, RV1.1
AUDIO_VOL: C3.1, RV1.2
GND: C1.1, C2.1, C4.1, C5.2, C6.1, H1.1, H2.1, H3.1, H4.1, J1.A1 (GND), J1.A12 (GND), J1.B1 (GND), J1.B12 (GND), J1.S1 (SHIELD), J2.3, J5.S, R1.2, R2.2, RV1.3, S1.1, S2.1, S3.1, S4.1, S5.1, S6.1, S7.1, S8.1, S9.1, S10.1, S11.1, S12.1, S13.1, U1.1 (GND), U2.2 (PGND@1), U2.10 (INR), U2.11 (GND), U2.15 (PGND@2)
unnamed: J1.A5 (CC1), R1.1
unnamed: J1.B5 (CC2), R2.1
unnamed: J4.1, J5.TN
unnamed: J4.2, U2.3 (-OUT_L)
unnamed: J1.A4 (VBUS), J1.A9 (VBUS), J1.B4 (VBUS), J1.B9 (VBUS), SW1.1 (A)
unnamed: J5.R, J5.T, U2.1 (+OUT_L)
unnamed: C3.2, U2.7 (INL)
unnamed: C4.2, U2.8 (VREF)
Note_1: J3.1, S1.2
Note_2: J3.2, S2.2
Note_3: J3.3, S3.2
Note_4: J3.4, S4.2
Note_5: J3.5, S5.2
Note_6: J3.6, S6.2
Note_7: J3.7, S7.2
Note_8: J3.8, S8.2
Note_9: J3.9, S9.2
Note_10: J3.10, S10.2
Note_11: J3.11, S11.2
Note_12: J3.12, S12.2
Note_13: J3.13, S13.2

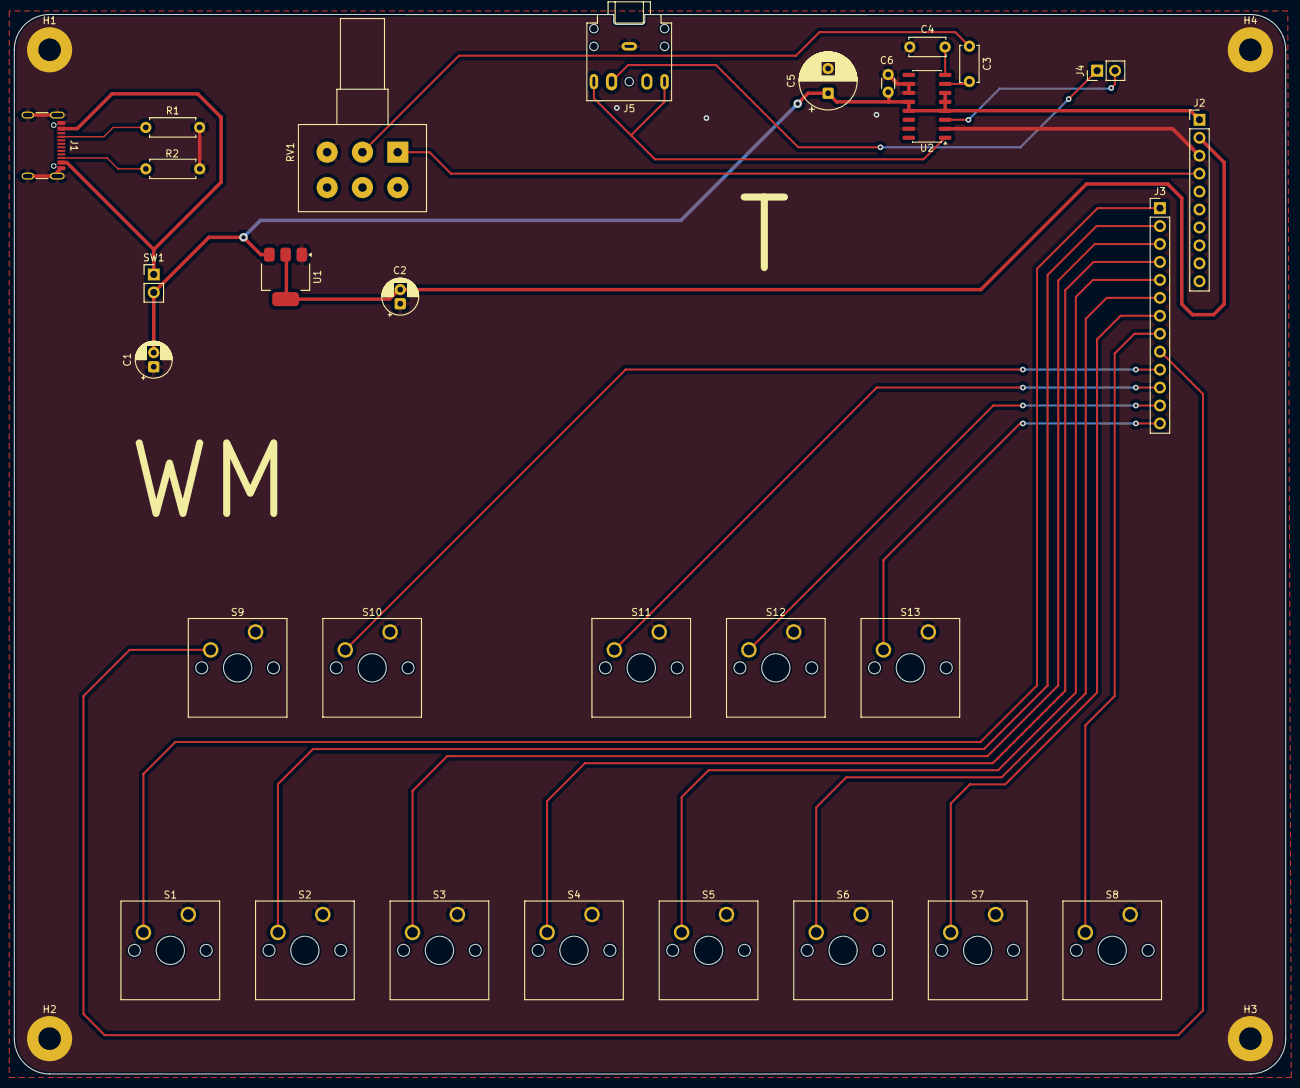
[picture p55: board Projet Piano.kicad_pcb from above]

Board: 2 copper layers, 180.0 x 150.0 mm, 34 parts (0 on the bottom side), 26 nets.
