clairemp25-prog/Projet-Piano-Num-rique-Ensea/projet clavier/Inc/main.h

#define B1_Pin GPIO_PIN_13
#define B1_GPIO_Port GPIOC
#define B1_EXTI_IRQn EXTI15_10_IRQn
#define SPI_CS_Pin GPIO_PIN_0
#define SPI_CS_GPIO_Port GPIOC
#define MAGNETO_STATUS_Pin GPIO_PIN_1
#define MAGNETO_STATUS_GPIO_Port GPIOC
#define USART_TX_Pin GPIO_PIN_2
#define USART_TX_GPIO_Port GPIOA
#define USART_RX_Pin GPIO_PIN_3
#define USART_RX_GPIO_Port GPIOA
#define LD2_Pin GPIO_PIN_5
#define LD2_GPIO_Port GPIOA
#define STEPPER_DIR_Pin GPIO_PIN_7
#define STEPPER_DIR_GPIO_Port GPIOA
#define GPS_PPS_Pin GPIO_PIN_4
#define GPS_PPS_GPIO_Port GPIOC
#define BTN_CENTER_Pin GPIO_PIN_5
#define BTN_CENTER_GPIO_Port GPIOC
#define touche_1_Pin GPIO_PIN_0
#define touche_1_GPIO_Port GPIOB
#define touche_2_Pin GPIO_PIN_1
#define touche_2_GPIO_Port GPIOB
#define touche_3_Pin GPIO_PIN_2
#define touche_3_GPIO_Port GPIOB
#define touche_6_Pin GPIO_PIN_11
#define touche_6_GPIO_Port GPIOB
#define touche_7_Pin GPIO_PIN_13
#define touche_7_GPIO_Port GPIOB
#define touche_8_Pin GPIO_PIN_14
#define touche_8_GPIO_Port GPIOB
#define touche_9_Pin GPIO_PIN_15
#define touche_9_GPIO_Port GPIOB
#define BTN_LEFT_Pin GPIO_PIN_6
#define BTN_LEFT_GPIO_Port GPIOC
#define LED_0_Pin GPIO_PIN_7
#define LED_0_GPIO_Port GPIOC
#define BTN_TOP_Pin GPIO_PIN_8
#define BTN_TOP_GPIO_Port GPIOC
#define BTN_RIGHT_Pin GPIO_PIN_9
#define BTN_RIGHT_GPIO_Port GPIOC
#define LED_2_Pin GPIO_PIN_8
#define LED_2_GPIO_Port GPIOA
#define STEPPER_MS1_Pin GPIO_PIN_11
#define STEPPER_MS1_GPIO_Port GPIOA
#define STEPPER_ENN_Pin GPIO_PIN_12
#define STEPPER_ENN_GPIO_Port GPIOA
#define TMS_Pin GPIO_PIN_13
#define TMS_GPIO_Port GPIOA
#define TCK_Pin GPIO_PIN_14
#define TCK_GPIO_Port GPIOA
#define ENC_BTN_Pin GPIO_PIN_15
#define ENC_BTN_GPIO_Port GPIOA
#define ENC_BTN_EXTI_IRQn EXTI15_10_IRQn
#define touche_4_Pin GPIO_PIN_4
#define touche_4_GPIO_Port GPIOB
#define touche_5_Pin GPIO_PIN_5
#define touche_5_GPIO_Port GPIOB
