clairemp25-prog/Projet-Piano-Num-rique-Ensea/(notices)

Notices in the files:
projet clavier/Src/main.c:
Copyright (c) 2026 STMicroelectronics.
All rights reserved.
This software is licensed under terms that can be found in the LICENSE file
projet clavier/Inc/main.h:
Copyright (c) 2025 STMicroelectronics.
